Daniel-Pedraglio/ROBO.666.Robotics.Project.Work/Documents/05 - Final Progress Report/Screenshot 2025-01-24 at 12.50.59.jpg

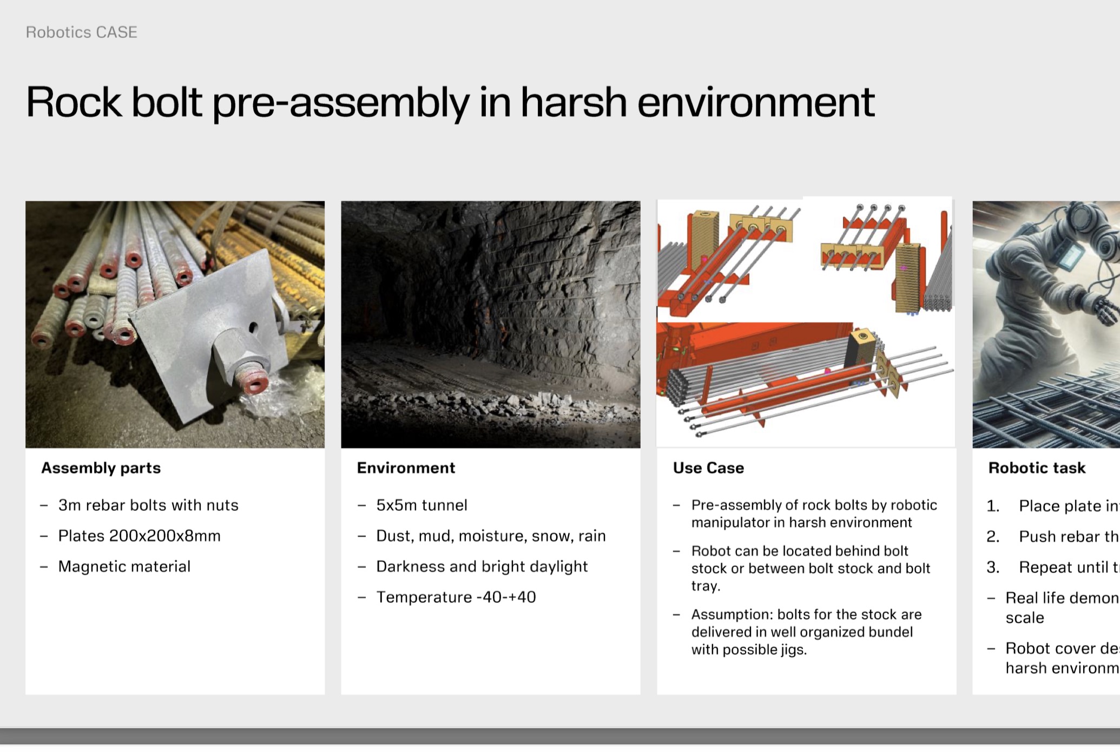
Documents/05 - Final Progress Report/Screenshot 2025-01-24 at 12.50.59.jpg
