Daniel-Pedraglio/ROBO.666.Robotics.Project.Work/Documents/06 - Final Report/Poster_Group2_IndustrialRobotsInHarshConditions.jpg

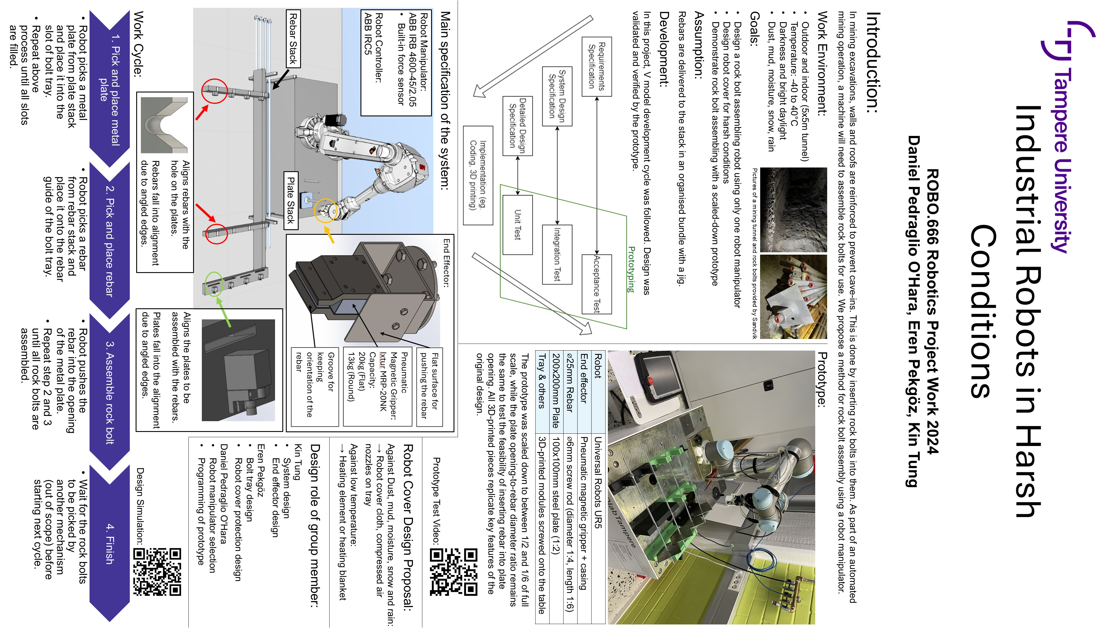
Documents/06 - Final Report/Poster_Group2_IndustrialRobotsInHarshConditions.jpg
