Daniel-Pedraglio/ROBO.666.Robotics.Project.Work/Documents/03 - Progress Report 1/Project Review 1.pptx

## Industrial robot in harsh conditions

Kin Tung
Eren Pekgöz
Daniel Pedraglio O'Hara

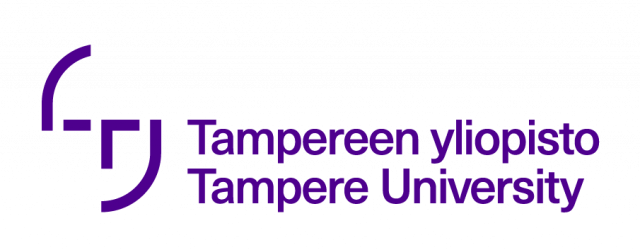
[picture p13: figure]

## Current Project Status

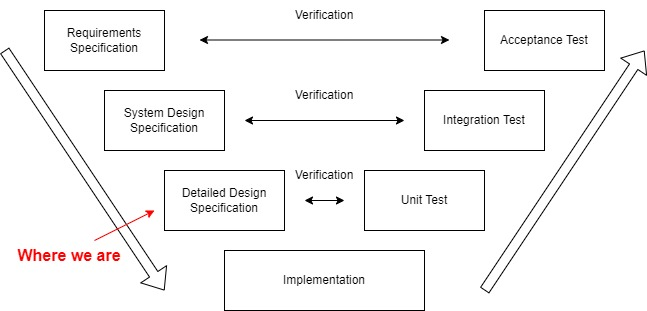
[picture p14: figure]

## Project Schedule Update

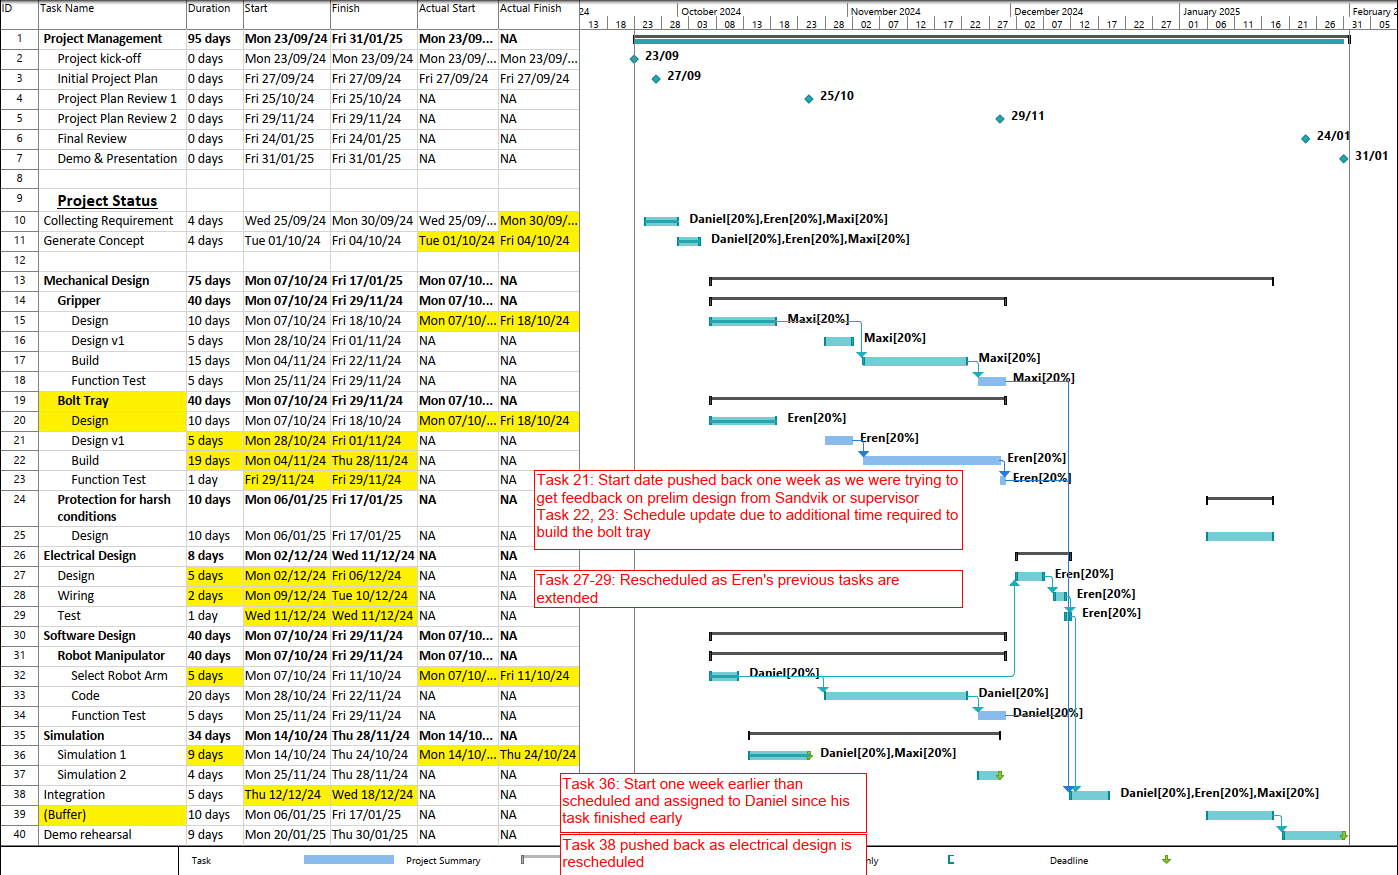
[picture p15: figure]

## Quick recap on requirements

- Main Goal:
Design a robot to assemble rock bolts (Rebar + Steel Plate)
- Environmental Conditions
  - Operating Environment: Indoor and outdoor.
  - Temperature Range: –40 to +40 °C.
  - Lighting Conditions: All lighting conditions, including direct sunlight and complete darkness.
  - Environmental factors: Dust, mud, moisture, snow and rain.
- Specification of materials
  - Steel Plate:
    - Dimension: 200x200x8 mm
    - Weight: 2.51kg
  - Rebar:
    - Dimension: 25mm Dia x 3000mm long
    - Weight: 11.56kg

Steel Weight Calculator, Steel Express
https://www.steelexpress.co.uk/steel-weight-calculator.html

## System Architecture

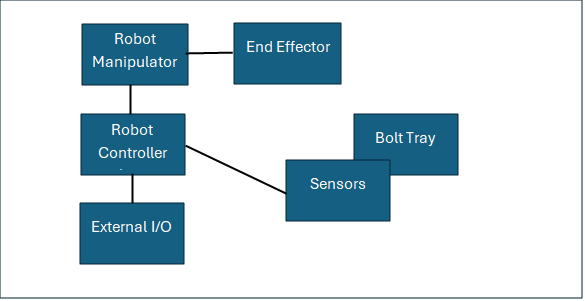
[picture p16: figure]

## Process Flow

Step 1: Initialisation of system.
Step 2: Robot picks up plate.
Step 3: Robot places the plate on the bolt tray.
Step 4: Repeat step 2 and 3 until 4 plates are placed on the bolt tray.
Step 5: Robot places the rebar on the bolt tray.
Step 6: Robot pushes the rebar into the plate.
Step 7: Repeat step 5 – 6 until bolt tray has 4 assembled rebars.
Step 8: Robot returns to home position and stand by.

## Bolt Tray

- Material: Steel construction for durability and strength
- Temperature Resistant: Can operate in both high and low temperature environments
- No moving parts: Ensures reliability, reduces maintenance need
- Fail-safe: Rebars remain secure even in power outages

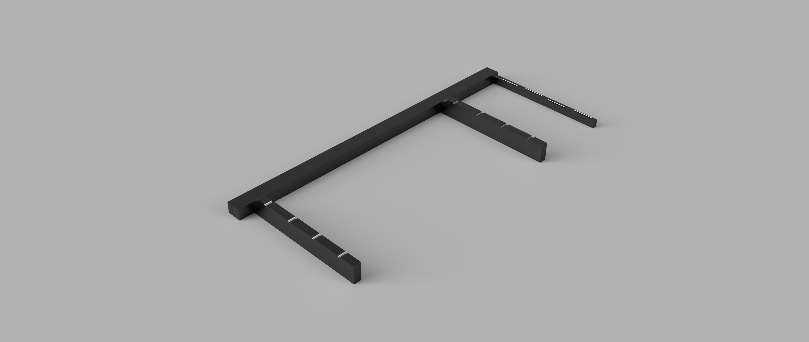
[picture p17: figure]
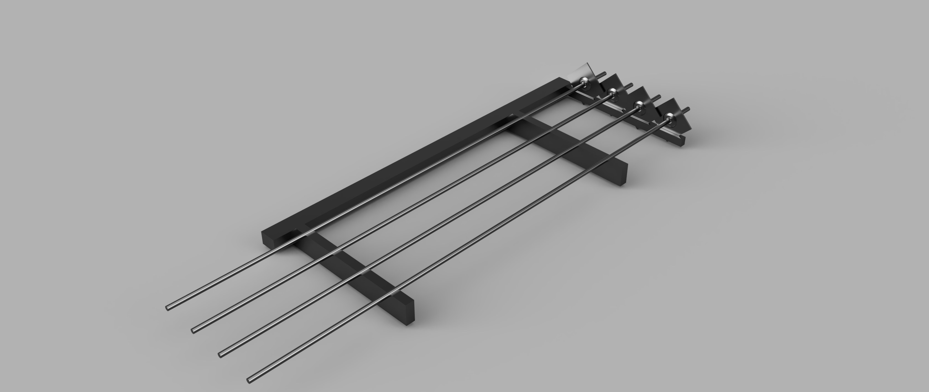
[picture p18: figure]

## Sensors on Bolt Tray

Sensor Type | Advantages | Disadvantages
Inductive Proximity Sensor | No moving parts, detects metal | Cannot detect non-metallic foreign objects
Limit Switch | Easy implementation, no calibration | Mechanical wear
Weight Sensor | High accuracy | Require a rather complex mechanical design of the bolt tray compared to other sensors
Laser Distance Sensor | 2 sensors are enough for the entire tray | Does not perform well with cylindrical or round objects

## Proposed Sensor

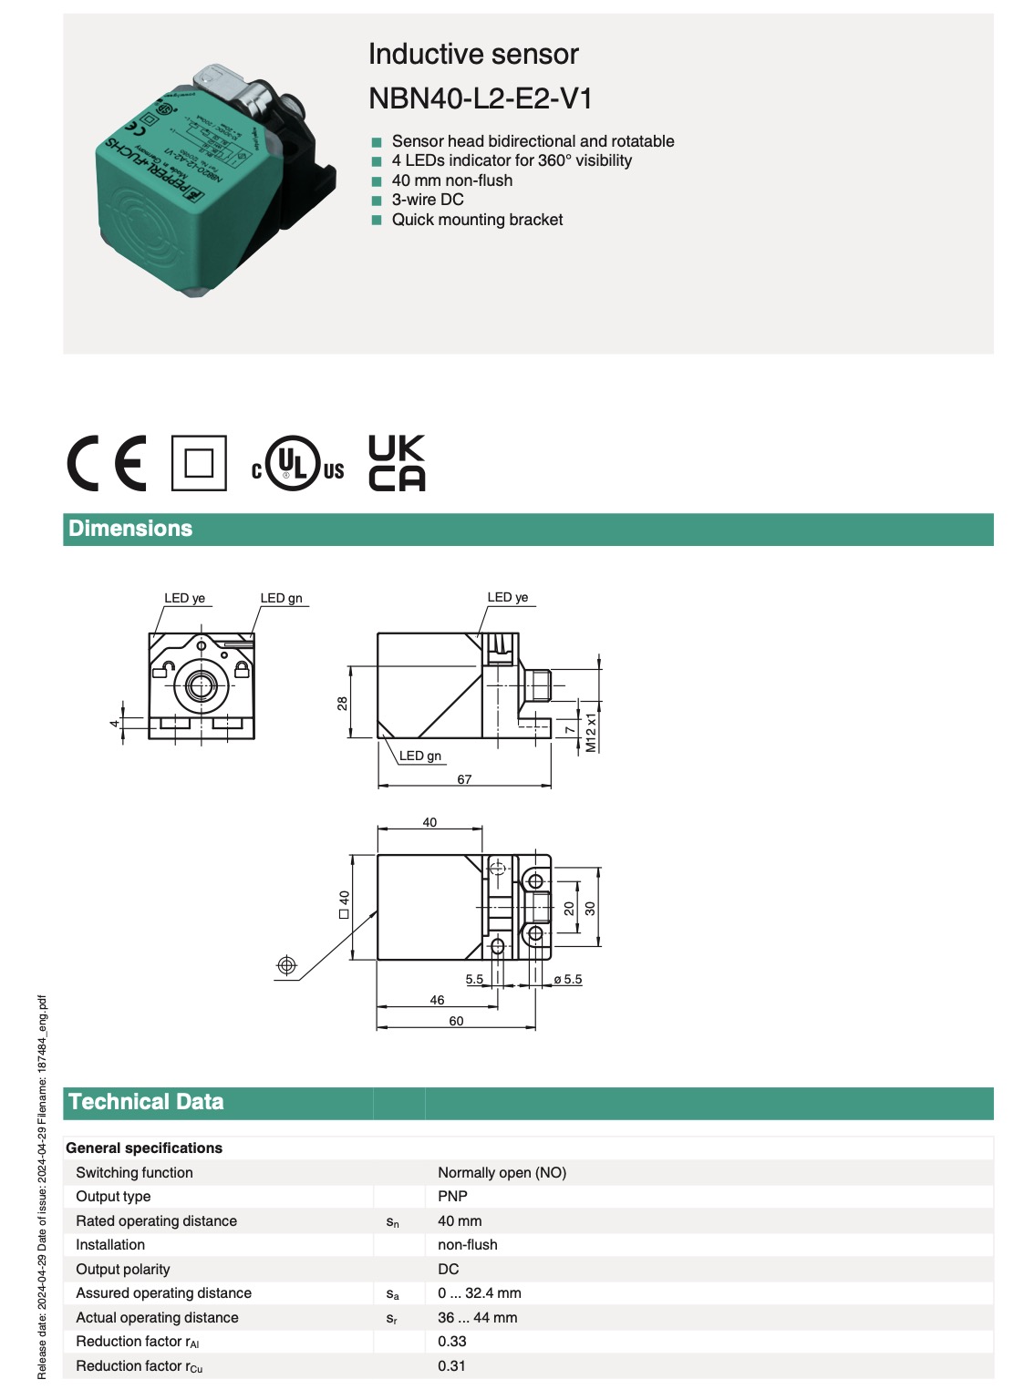
[picture p19: figure]

Pepperl+Fuchs NBN40-L2-E2-V1:
Operating Distance 0...44mm
Normally Open Switch Mechanism
10-30V DC Operating Voltage

## End Effector (1/3)

Functions:
  1. Pick and plate rebar
  2. Pick and plate metal plate
  3. Push rebar into the plate

## End Effector (2/3)

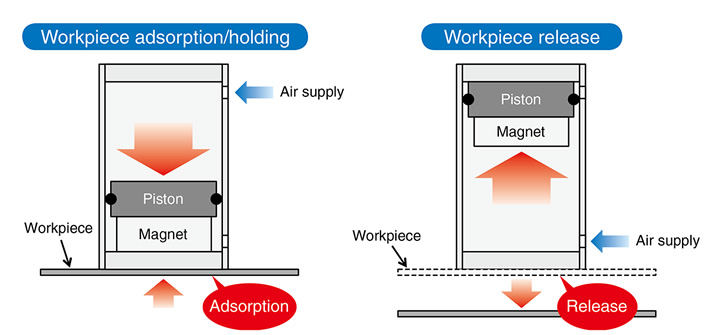
[picture p20: figure]

https://www.smcworld.com/newproducts/en/mhm/images/02b.jpg

- Magnetic Gripper
  - Magnetic force stronger in low temperature
  - No external moving parts
    - Lubrication not necessary => No frozen lubricant problem
    - No frozen joint problem in wet, sub-zero temperature
- Pneumatic Magnetic Gripper
  - Permanent magnet
  - Fail-safe design
    - pneumatic pressure/power = off
    - no pneumatic pressure/no power = on

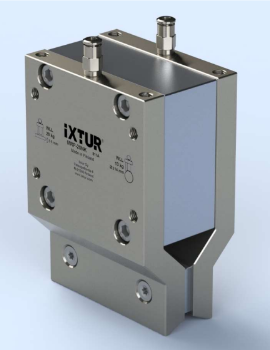
[picture p21: figure]

IXTUR MRP-20NK
- IP67
- Lifting capacity with Safety Factor 3 = 13kg for solid round object (ø≥14mm)

IXTUR MRP-20NK Brochure
https://www.ixtur.com/wp-content/uploads/2023/08/Brochure_MRP-20NK_ENG112018.pdf

## End Effector (3/3)

- Rest of the end effector made of 304 stainless steel or other non-magnetic materials

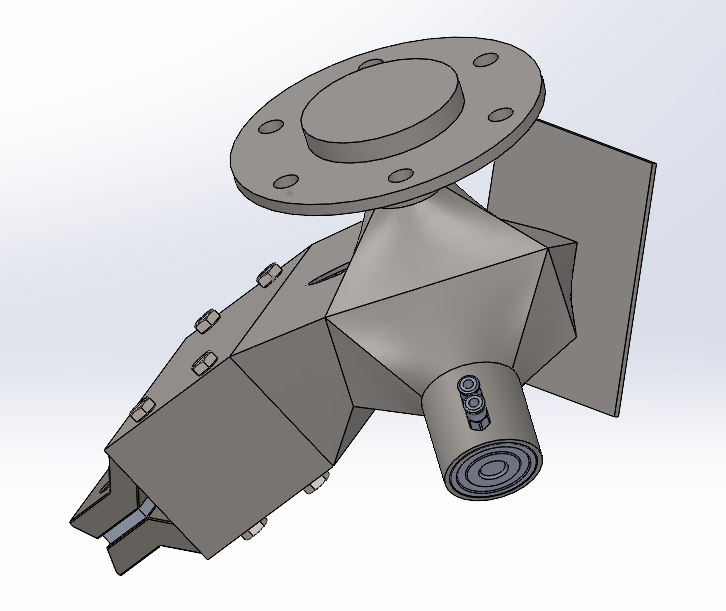
[picture p22: figure]
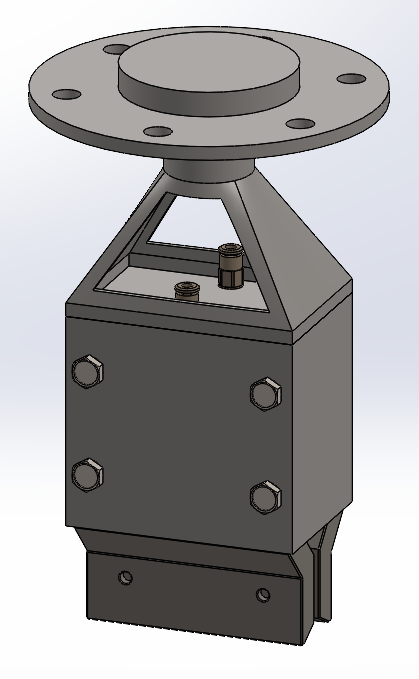
[picture p23: figure]
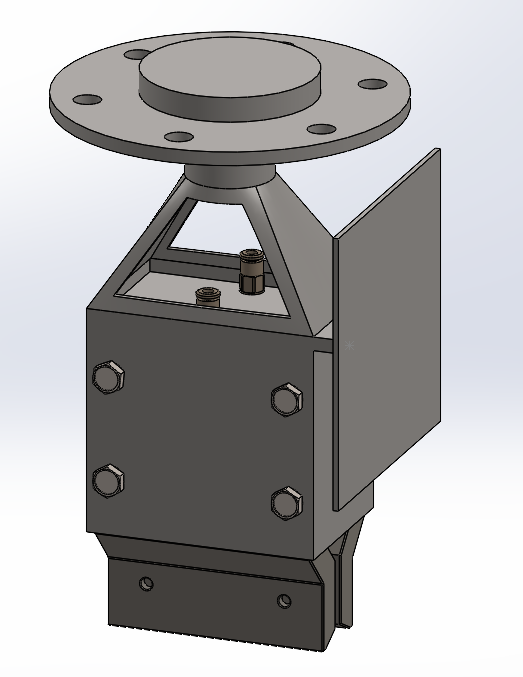
[picture p24: figure]

Ver. 0

Ver. 0.1

Ver. 0.2

## Robot Manipulator Requirements

- Reach from edge of structure with end effector: 1920 mm.
- Good work envelope for objects near and up to 400 mm below it.
- Payload of 15,5 kg at 1155 mm.
- Available in Visual Components.

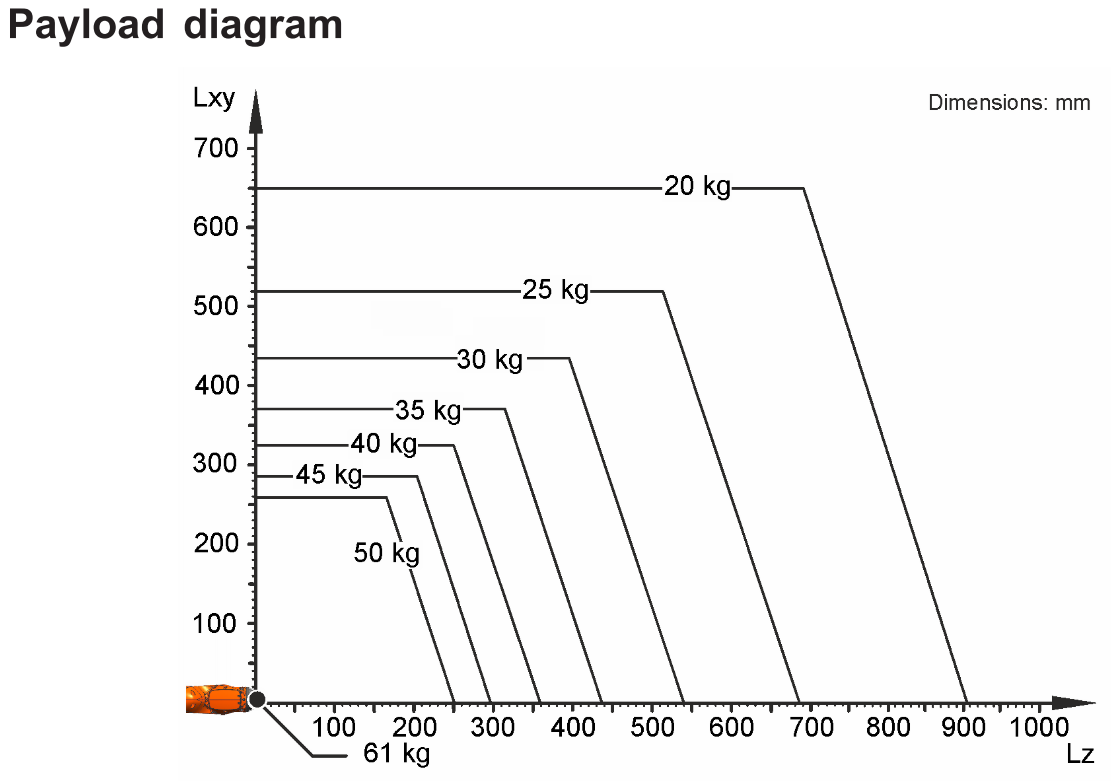
[picture p25: figure]

## Robot Manipulator (1/2)

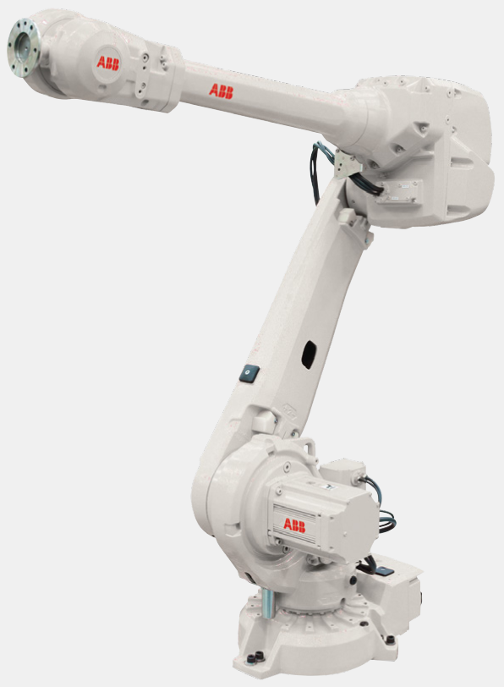
[picture p26: figure]

- ABB IRB 4600-45/2.05
- Reach: 2.05m
- Payload: 45kg
- IP67

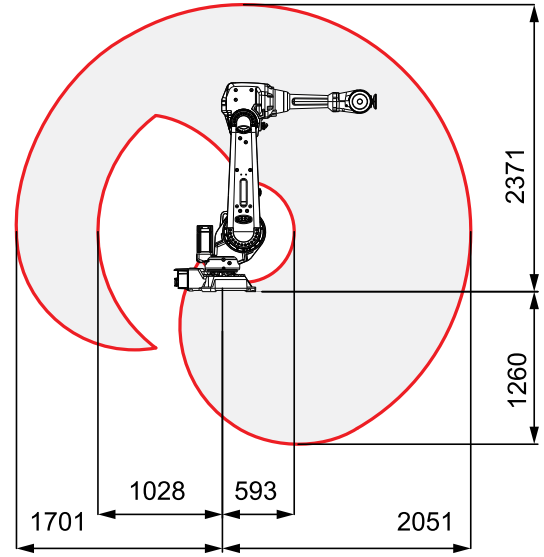
[picture p27: figure]

## Robot Manipulator (2/2)

- Electrical connection: 200-600 V, 50-60 Hz
- Weight: 445kg
- Operating temperature: 5° to 45° C
  - Will require heating in colder environments
- Humidity: max 95%

## Alternative Robot Manipulators

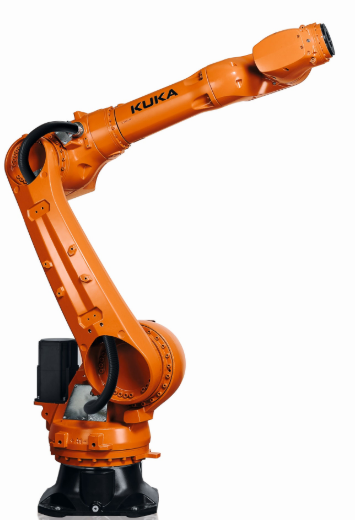
[picture p28: figure]

- Kuka KR 50 R2100
  - 5 kg more payload, 51mm more reach, operates from 0° to 55° C.
  - Almost 20% heavier.

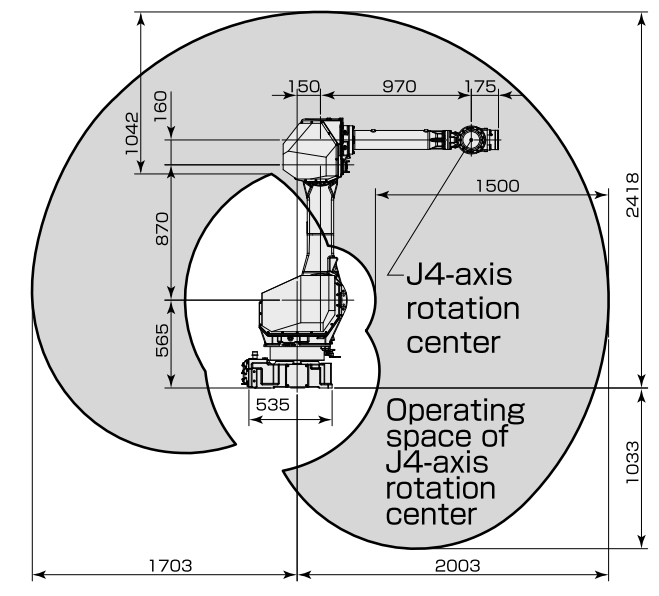
[picture p29: figure]

- Fanuc M-710/50-20C-5X
  - 5kg more payload, operates from 0° to 45° C.
  - 20% heavier, less humidity allowed, worse work envelope due to 5 joints

## Simulation

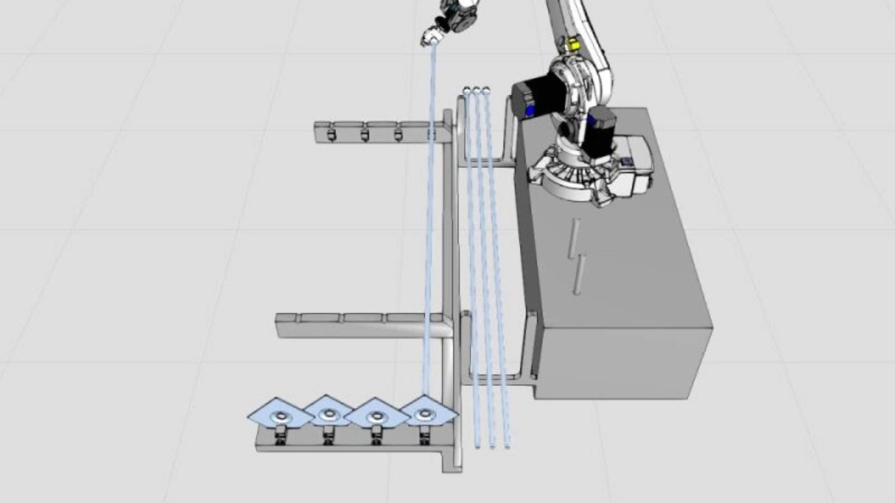
[picture p30: figure]

## From Now to Next Progress Review

- Design v1, build and functional test for end effector and bolt tray*
- Coding robot manipulator*
*If we manage to get in touch with our supervisor or Sandvik's representative to discuss prototyping

## Q&A

## Thank you!
