Daniel-Pedraglio/ROBO.666.Robotics.Project.Work/Documents/01 - Initial Project Plan/Initial ProjectTimeline.pdf

Start Mon 23/09/24

Finish
Fri 31/01/25
30 Sep '24 | 14 Oct '24 | 28 Oct '24 | 11 Nov '24 | 25 Nov '24 | 09 Dec '24 | 23 Dec '24 | 06 Jan '25 | 20 Jan '25 Gripper
| | Ge Ge | Mon 07/10/24 - Fri 29/11/24 Mon 07/10/24 - Fri 29/11/24 | Protection for h Mon 06/01/25 - Colle Wed Protection for h Mon 06/01/25 - Colle Wed
Tray Tray Mon 07/10/24 - Mon 04/11/24 Mon 07/10/24 - Mon 04/11/24 | Electrical Design Electrical Design
Mon 18/11/24 - Fri 06/12/24 Robot Arm

Mon 07/10/24 - Fri 29/11/24

Tu | Demo rehears Mon 20/01/25 Inte Mon Today

Start Mon 23/09/24

Finish
Fri 31/01/25
30 Sep '24 | 14 Oct '24 | 28 Oct '24 | 11 Nov '24 | 25 Nov '24 | 09 Dec '24 | 23 Dec '24 | 06 Jan '25 | 20 Jan '25 Gripper

Mon 18/11/24 - Fri 06/12/24 Robot Arm

Mon 07/10/24 - Fri 29/11/24

Tu | Demo rehears Mon 20/01/25 Inte Mon
