Daniel-Pedraglio/ROBO.666.Robotics.Project.Work/Documents/11 - Requirements Specification/Requirements from Sandvik.pdf

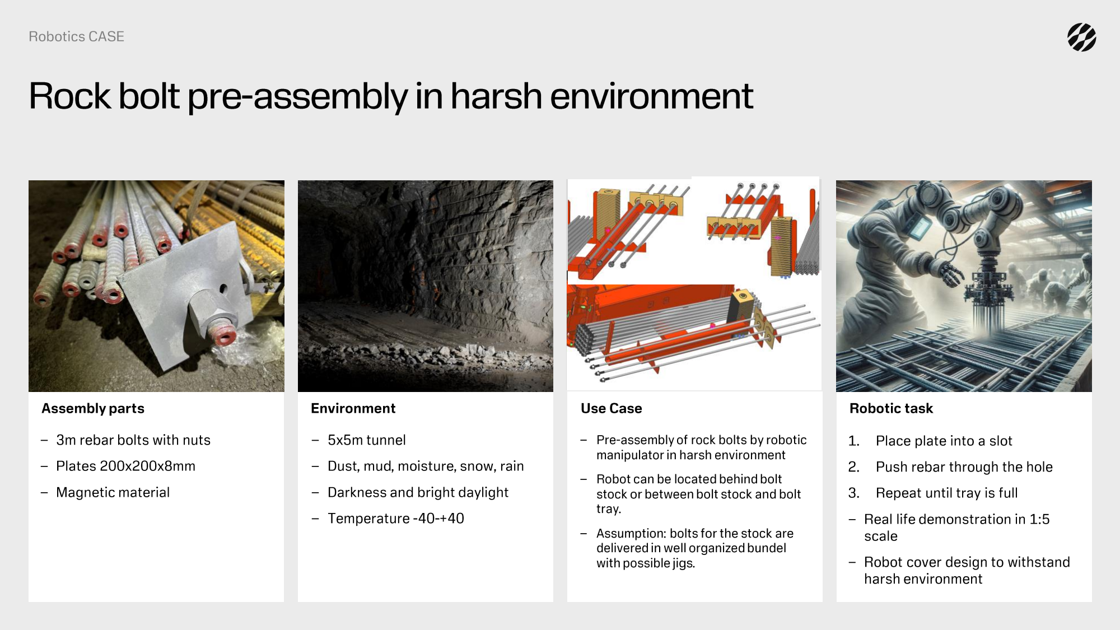
[picture p73: page 2]
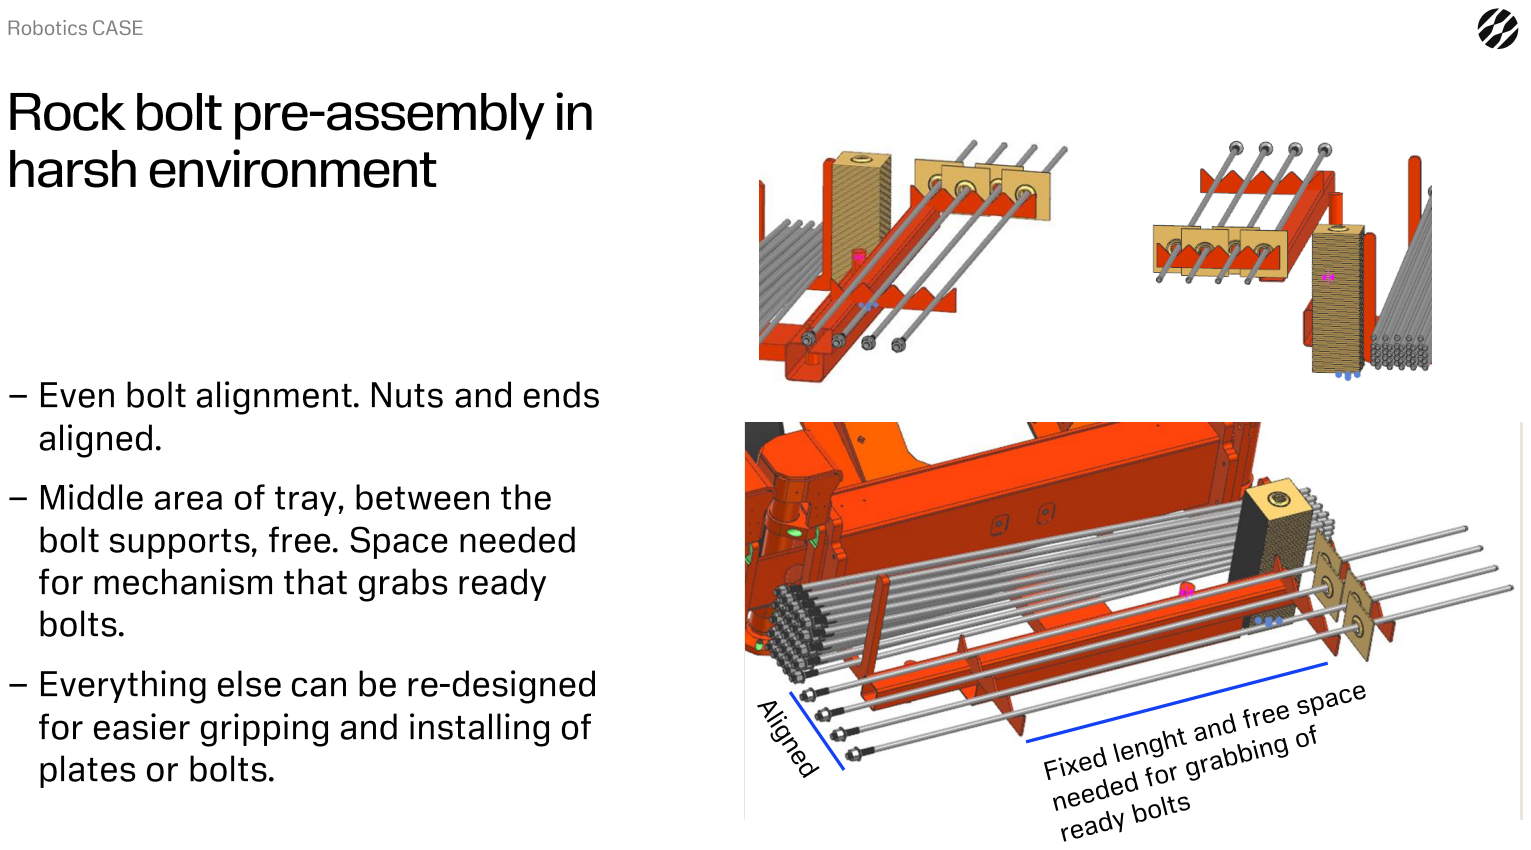
[picture p74: page 3]
