Daniel-Pedraglio/ROBO.666.Robotics.Project.Work/Design/Simulation/Tunnel1.png

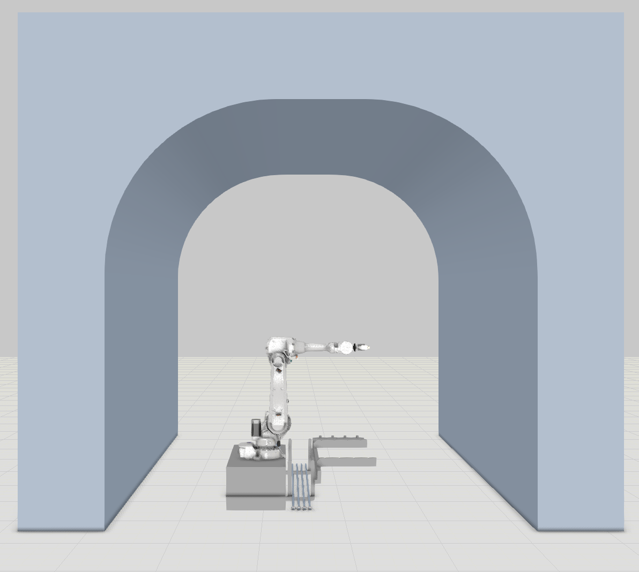
Design/Simulation/Tunnel1.png
