Daniel-Pedraglio/ROBO.666.Robotics.Project.Work/Design/Simulation/Tunnel2.png

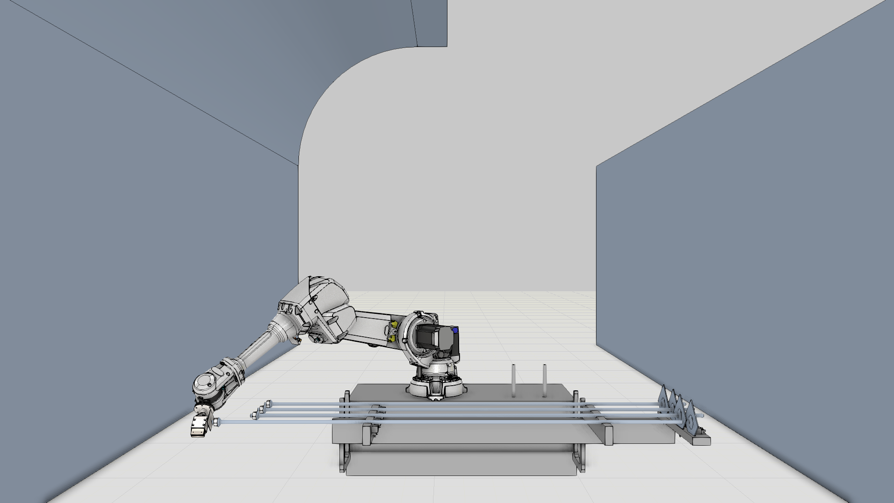
Design/Simulation/Tunnel2.png
