Daniel-Pedraglio/ROBO.666.Robotics.Project.Work/Documents/11 - Requirements Specification/Project Introduction Slide.jpg

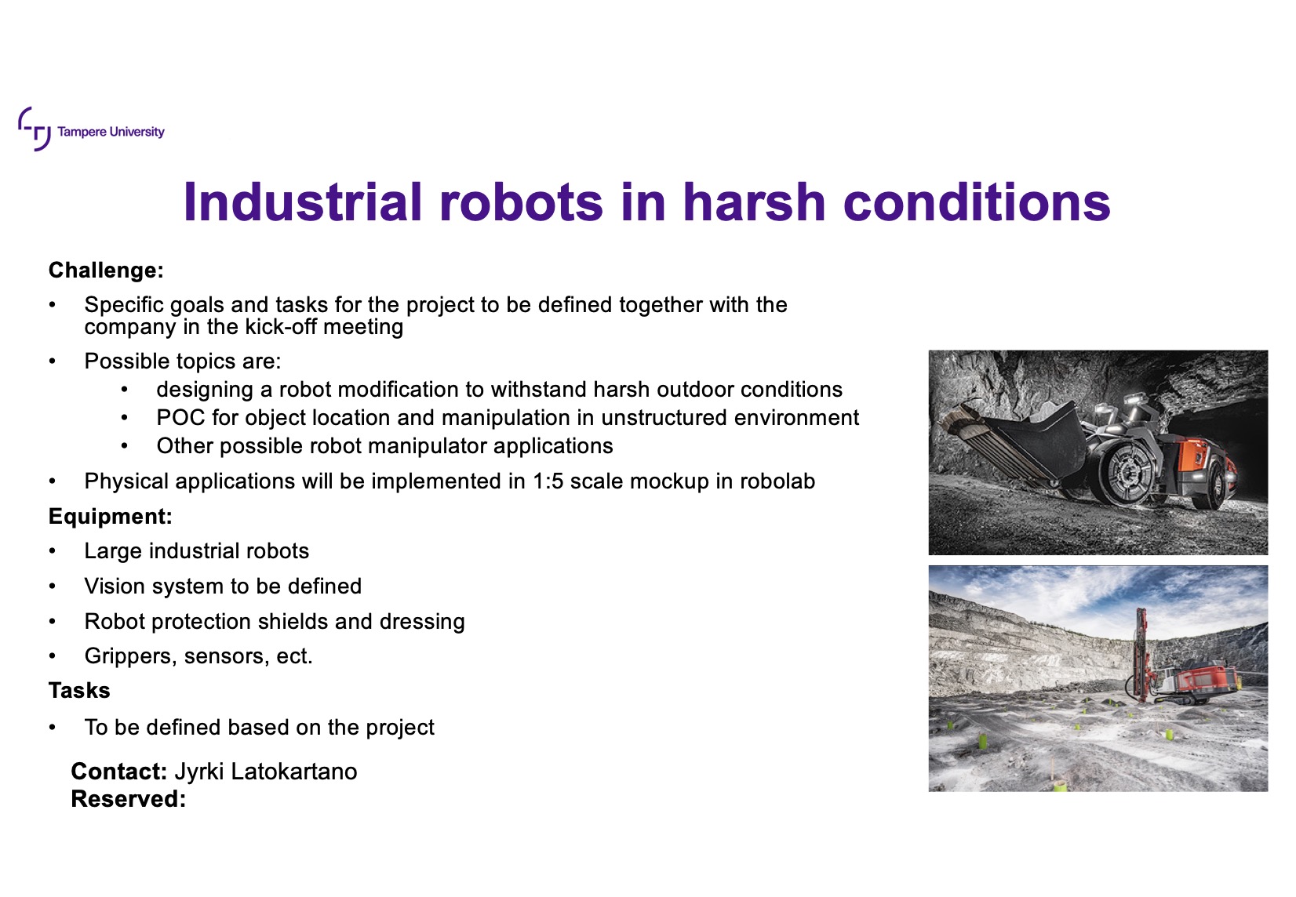
Documents/11 - Requirements Specification/Project Introduction Slide.jpg
