Daniel-Pedraglio/ROBO.666.Robotics.Project.Work/Design/Material CAD/Tunnel.SLDPRT

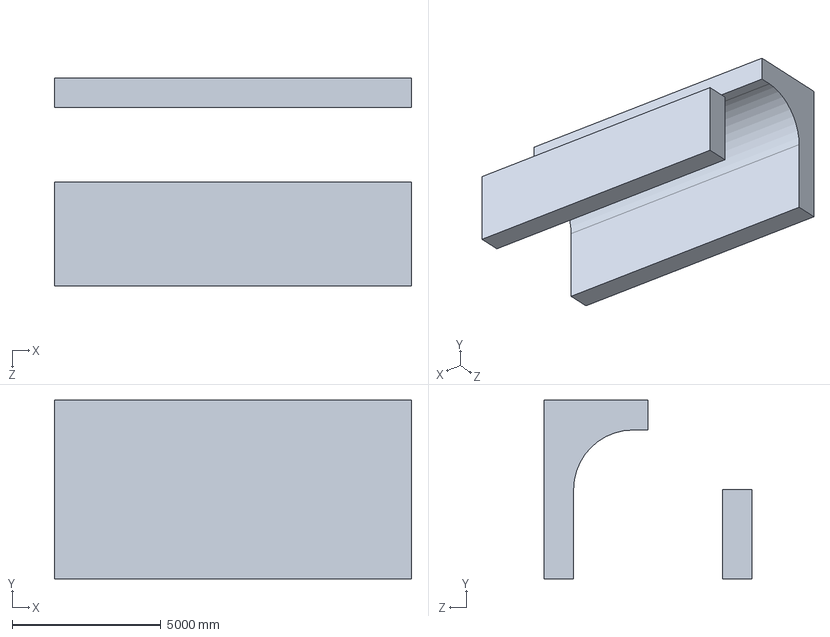
[picture p78: CAD file, 2025-01-27]
Design/Material CAD/Tunnel.SLDPRT
12000.0 x 6000.0 x 7000.0 mm
