Daniel-Pedraglio/ROBO.666.Robotics.Project.Work/Prototype/End Effector/3D Print/Adaptor(Upper).3mf

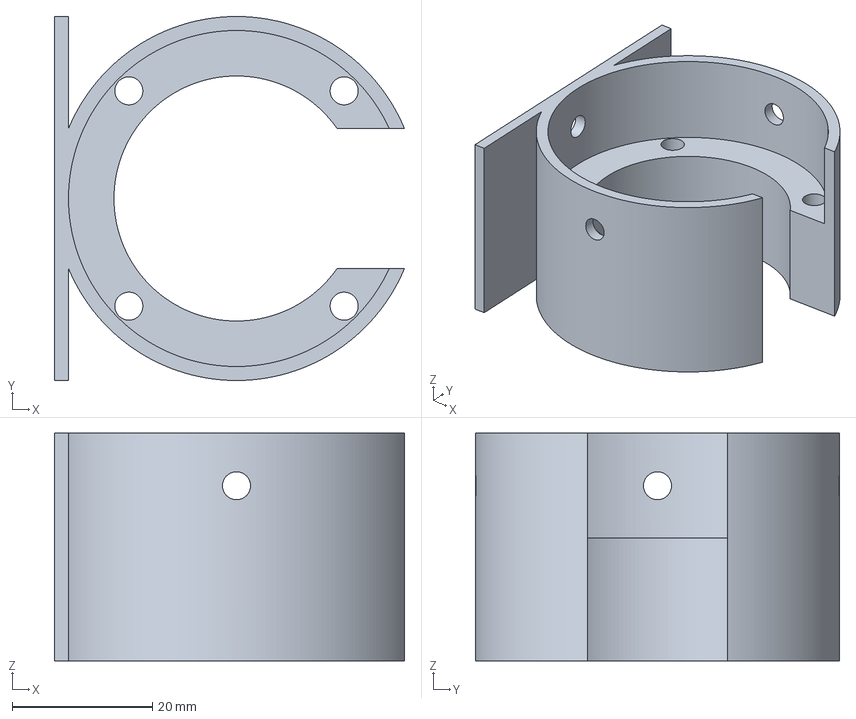
[picture p79: CAD file, 2025-01-27]
Prototype/End Effector/3D Print/Adaptor(Upper).3mf
50.0 x 52.0 x 32.5 mm
