Daniel-Pedraglio/ROBO.666.Robotics.Project.Work/Prototype/End Effector/CAD/Adaptor_groove0.5.SLDPRT

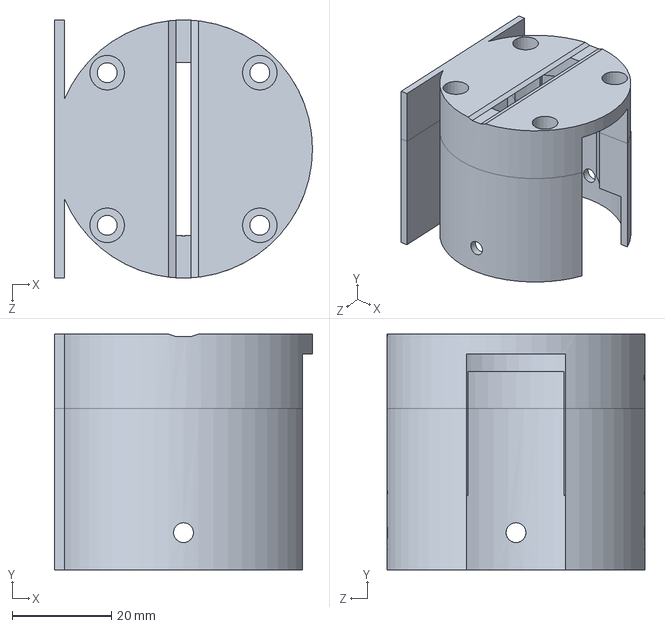
[picture p80: CAD file, 2025-01-27]
Prototype/End Effector/CAD/Adaptor_groove0.5.SLDPRT
52.0 x 47.5 x 52.0 mm
