Daniel-Pedraglio/ROBO.666.Robotics.Project.Work/Prototype/Material CAD/plate_base_print.step

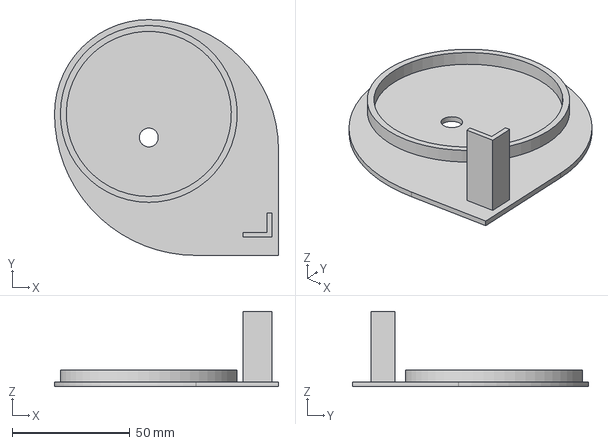
[picture p81: CAD file, 2025-01-27]
Prototype/Material CAD/plate_base_print.step
95.0 x 100.0 x 32.0 mm
