Daniel-Pedraglio/ROBO.666.Robotics.Project.Work/Prototype/End Effector/3D Print/Adaptor(Lower)_groove02.3mf

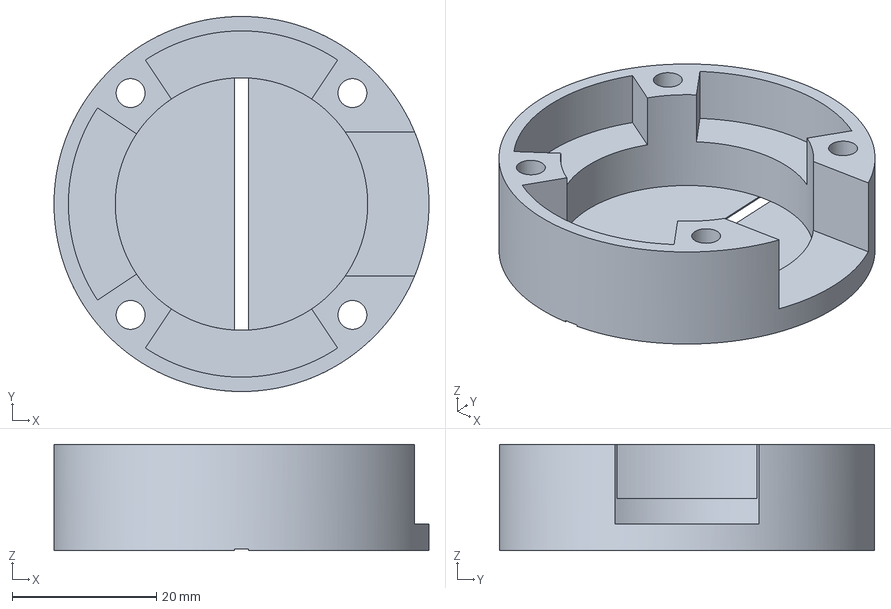
[picture p82: CAD file, 2025-01-27]
Prototype/End Effector/3D Print/Adaptor(Lower)_groove02.3mf
52.0 x 52.0 x 14.7 mm
