Daniel-Pedraglio/ROBO.666.Robotics.Project.Work/Prototype/End Effector/CAD/Adaptor_groove0.2.SLDPRT

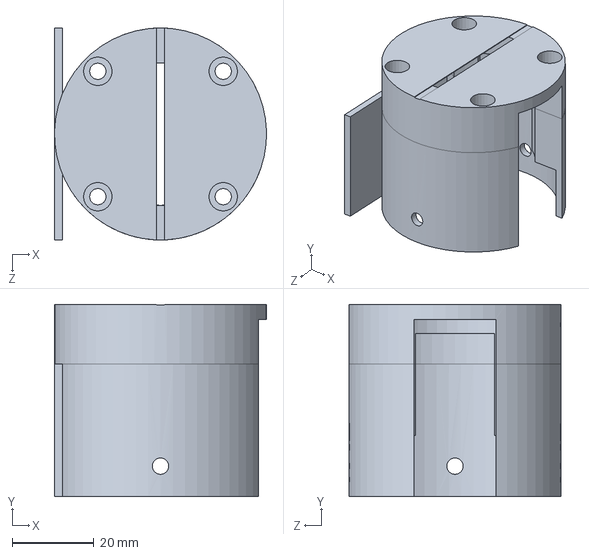
[picture p83: CAD file, 2025-01-27]
Prototype/End Effector/CAD/Adaptor_groove0.2.SLDPRT
52.0 x 47.2 x 52.0 mm
