Daniel-Pedraglio/ROBO.666.Robotics.Project.Work/Prototype/Material CAD/rebar_holder_ladder.step

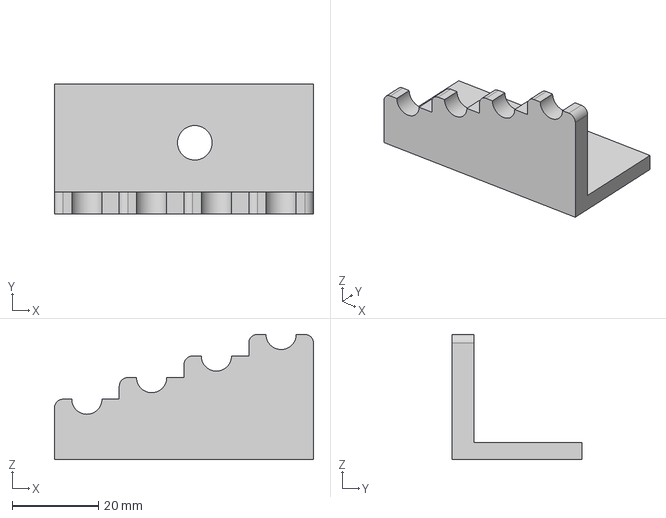
[picture p84: CAD file, 2025-01-27]
Prototype/Material CAD/rebar_holder_ladder.step
60.0 x 30.0 x 29.0 mm
