Daniel-Pedraglio/ROBO.666.Robotics.Project.Work/Prototype/End Effector/3D Print/Adaptor(Lower)_groove05.3mf

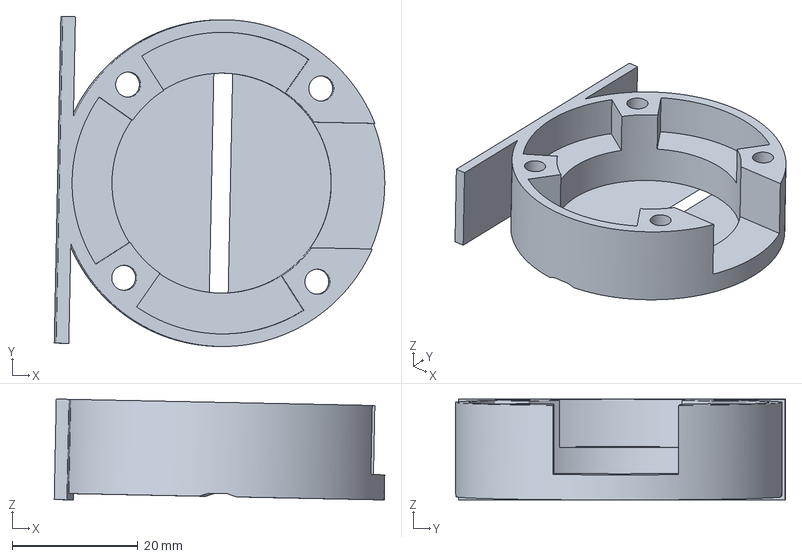
[picture p85: CAD file, 2025-01-27]
Prototype/End Effector/3D Print/Adaptor(Lower)_groove05.3mf
52.6 x 52.5 x 16.1 mm
