Daniel-Pedraglio/ROBO.666.Robotics.Project.Work/Design/Material CAD/Rebar Rack and Plate Stack.STEP

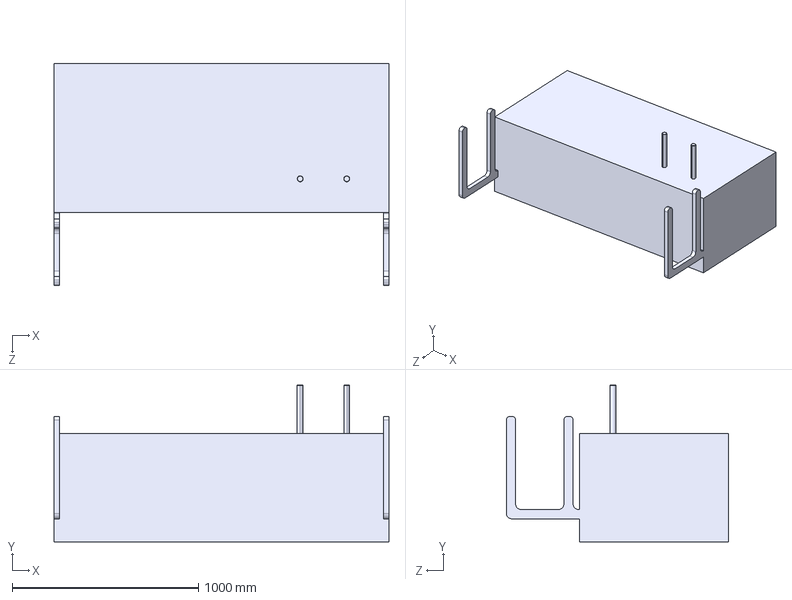
[picture p86: CAD file, 2025-01-27]
Design/Material CAD/Rebar Rack and Plate Stack.STEP
1798.9 x 843.0 x 1193.8 mm
