Daniel-Pedraglio/ROBO.666.Robotics.Project.Work/Design/Bolt Tray/tray_rack_sensors.step

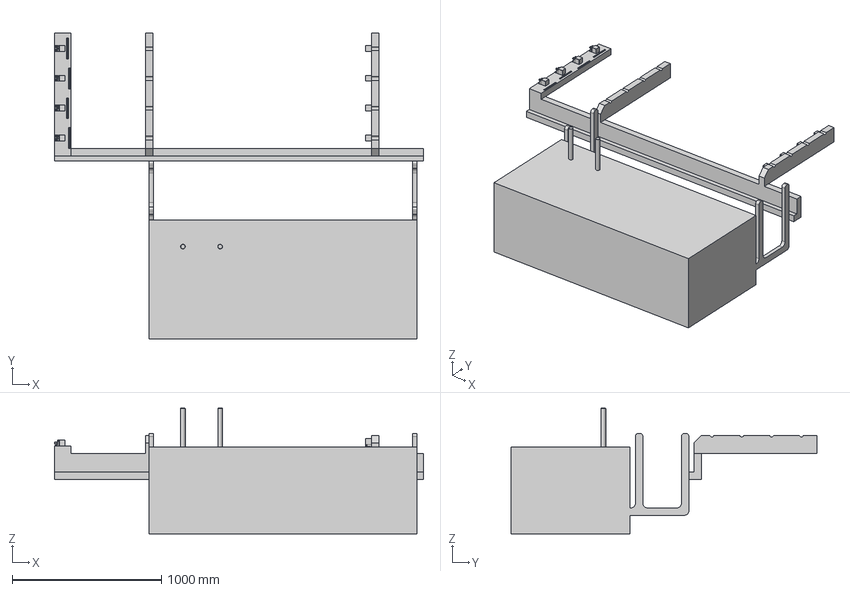
[picture p87: CAD file, 2025-02-04]
Design/Bolt Tray/tray_rack_sensors.step
2476.0 x 2053.8 x 843.0 mm
