Daniel-Pedraglio/ROBO.666.Robotics.Project.Work/Prototype/Bolt Tray/RebarGuide_PrintSlim.step

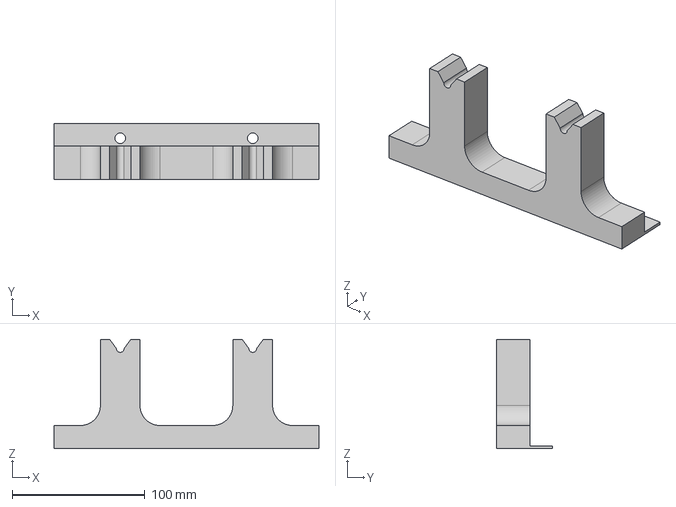
[picture p88: CAD file, 2025-02-04]
Prototype/Bolt Tray/RebarGuide_PrintSlim.step
200.0 x 42.0 x 82.5 mm
