Daniel-Pedraglio/ROBO.666.Robotics.Project.Work/Prototype/Bolt Tray/PlateHolder_PrintSlim.step

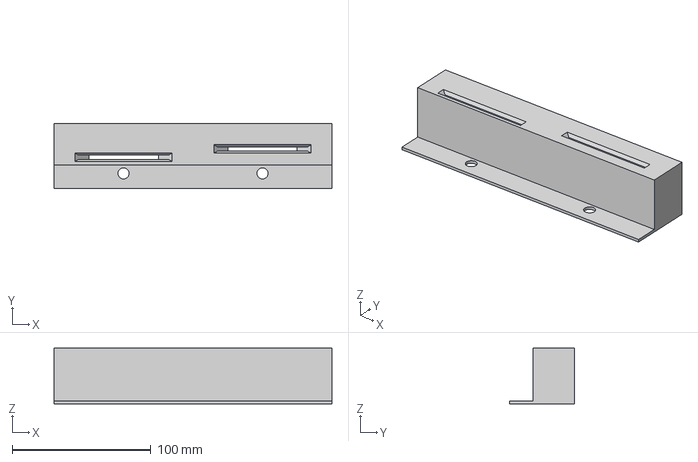
[picture p89: CAD file, 2025-02-04]
Prototype/Bolt Tray/PlateHolder_PrintSlim.step
200.0 x 47.0 x 40.0 mm
