Daniel-Pedraglio/ROBO.666.Robotics.Project.Work/Design/End Effector/CAD/EndEffector_v1.1.SLDASM

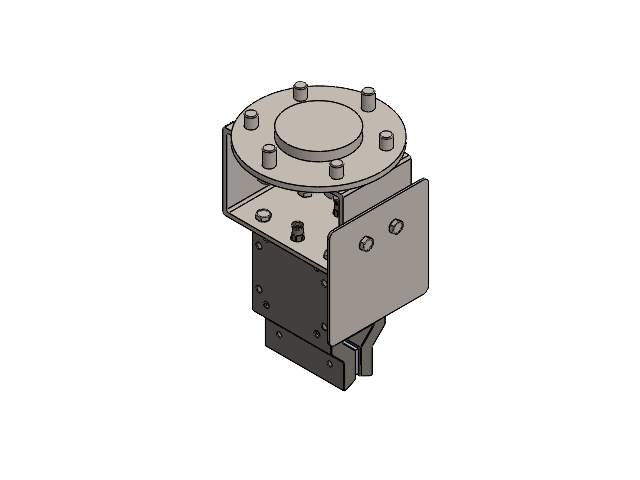
[picture p90: CAD file, 2025-01-27]
Design/End Effector/CAD/EndEffector_v1.1.SLDASM
EndEffector(1Gripper)_v0.4_Flange
EndEffector(1Gripper)_v0.4_Angle
EndEffector(1Gripper)_v0.4_PushPlate
MRP-20NK 3d-model
formed hex screw_am x 12
hex nut style 1_am x 2
