Daniel-Pedraglio/ROBO.666.Robotics.Project.Work/Design/Material CAD/Plate.SLDASM

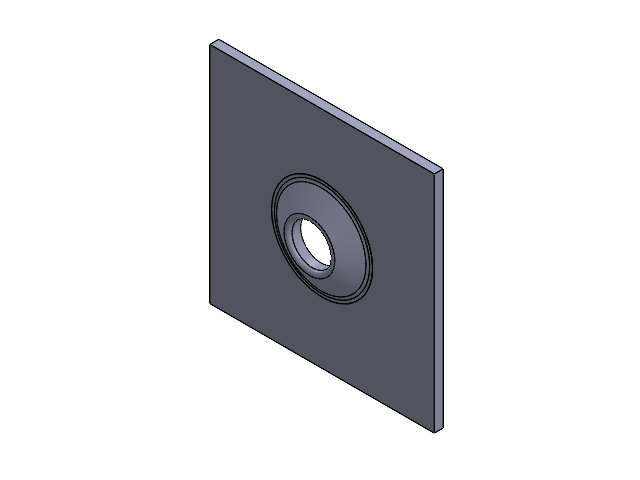
[picture p91: CAD file, 2025-01-27]
Design/Material CAD/Plate.SLDASM
Plate2
Plate1
