Daniel-Pedraglio/ROBO.666.Robotics.Project.Work/Design/Material CAD/Rebar.SLDASM

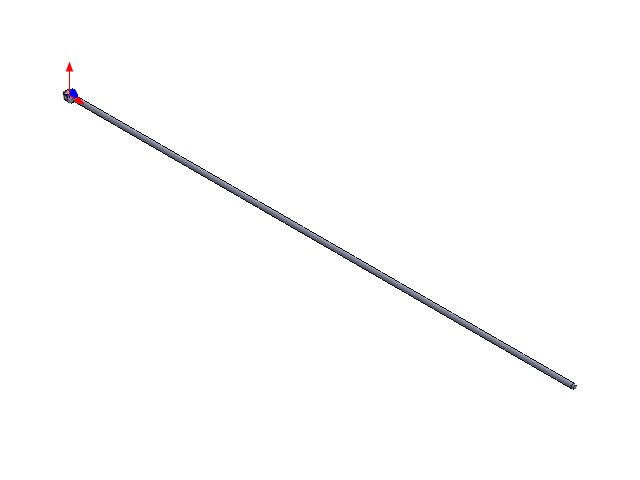
[picture p92: CAD file, 2025-01-27]
Design/Material CAD/Rebar.SLDASM
Rebar
Washer
hex nut style 1 gradeab_iso
