Daniel-Pedraglio/ROBO.666.Robotics.Project.Work/(list of files, cad)

Other CAD files:
Design/Material CAD/Rebar Rack and Plate Stack.SLDPRT
Prototype/Bolt Tray/PlateHolder_PrintSlim.stl
Prototype/Bolt Tray/RebarGuide_PrintSlim.stl
Prototype/Material CAD/plate_base_print.stl
Prototype/Material CAD/rebar_holder_ladder.stl
