Daniel-Pedraglio/ROBO.666.Robotics.Project.Work/Documents/03 - Progress Report 1/Project Schedule (Progress Review 1).pdf

9 | Project Status | | | | NA | NA

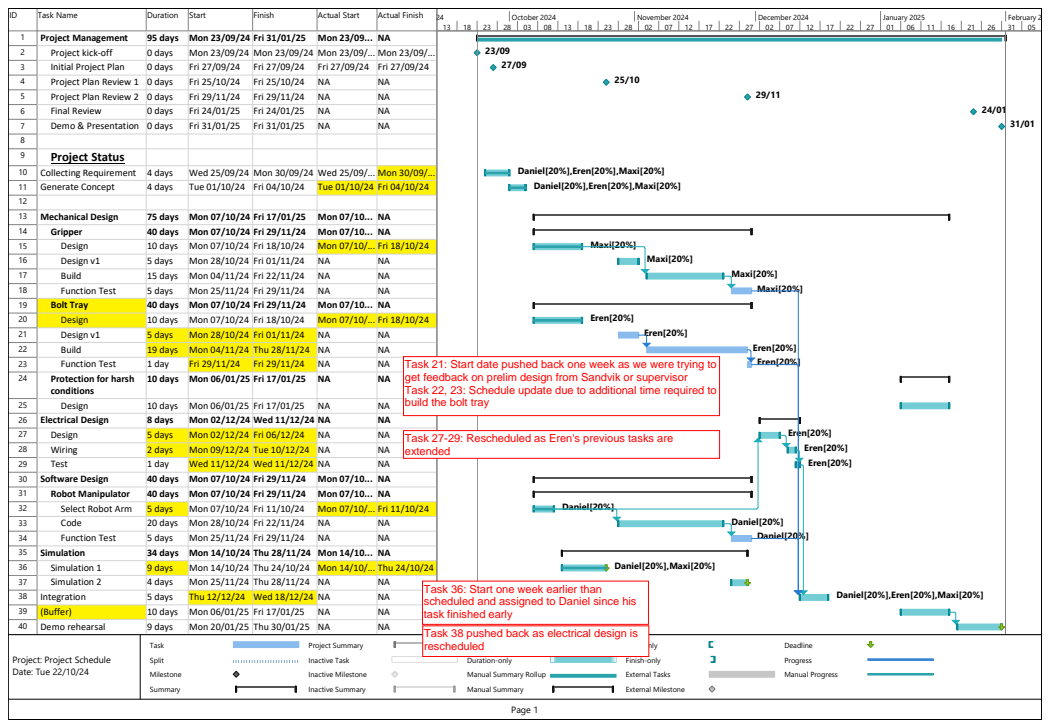
[picture p93: page 1]
Maxi[20%]; Maxi[20%] Maxi[20%]; Eren[20%]; Eren[20%] Eren[20%]; Eren[20%] Eren[20%] Eren[20%]; Daniel[20%]; Daniel[20%] Daniel[20%]; Daniel[20%],Maxi[20%]; October 2024; November 2024; December 2024; January 2025; February 2025; Task; Split; Summary; Project Summary; Inactive Task; Inactive Summary; Manual Task; Duration-only; Manual Summary; Start-only; Finish-only; External Milestone; Deadline; Progress; Page 1

ID | Task Name | Duration | Start | Finish | Actual Start | Actual Finish
1 | Project Management | 95 days | Mon 23/09/24 Fri 31/01/25 | | Mon 23/09... | NA
2 | Project kick-off | 0 days | Mon 23/09/24 | Mon 23/09/24 | Mon 23/09/...
3 | Initial Project Plan | 0 days | Fri 27/09/24 | Fri 27/09/24 | Fri 27/09/24 | Fri 27/09/24
4 | Project Plan Review 1 | 0 days | Fri 25/10/24 | Fri 25/10/24 | NA | NA
5 | Project Plan Review 2 | 0 days | Fri 29/11/24 | Fri 29/11/24 | NA | NA
6 | Final Review | 0 days | Fri 24/01/25 | Fri 24/01/25 | NA | NA
7 | Demo & Presentation | 0 days | Fri 31/01/25 | Fri 31/01/25 | NA | NA

10 | Collecting Requirement | 4 days | Wed 25/09/24 | Mon 30/09/24 | Wed 25/09/... Mon 30/09/...
11 | Generate Concept | 4 days | Tue 01/10/24 | Fri 04/10/24 | Tue 01/10/24 | Fri 04/10/24
12
13 | Mechanical Design | 75 days | Mon 07/10/24 Fri 17/01/25 | | Mon 07/10... | NA
14 | Gripper | 40 days | Mon 07/10/24 Fri 29/11/24 | | Mon 07/10... | NA
15 | Design | 10 days | Mon 07/10/24 | Fri 18/10/24 | Mon 07/10/... Fri 18/10/24
16 | Design v1 | 5 days | Mon 28/10/24 | Fri 01/11/24 | NA | NA
17 | Build | 15 days | Mon 04/11/24 | Fri 22/11/24 | NA | NA
18 | Function Test | 5 days | Mon 25/11/24 | Fri 29/11/24 | NA | NA
19 | Bolt Tray | 40 days | Mon 07/10/24 Fri 29/11/24 | | Mon 07/10... | NA
20 | Design | 10 days | Mon 07/10/24 | Fri 18/10/24 | Mon 07/10/... Fri 18/10/24
21 | Design v1 | 5 days | Mon 28/10/24 | Fri 01/11/24 | NA | NA
22 | Build | 19 days | Mon 04/11/24 | Thu 28/11/24 | NA | NA
23 | Function Test | 1 day | Fri 29/11/24 | Fri 29/11/24 | NA | NA
24 Protection for harsh | conditions | 10 days | Mon 06/01/25 Fri 17/01/25 | | NA | NA

Daniel[20%],Eren[20%],Maxi[20%]

25 | Design | 10 days | Mon 06/01/25 | Fri 17/01/25 | NA | NA
26 | Electrical Design | 8 days | Mon 02/12/24 Wed 11/12/24 NA | | | NA
27 | Design | 5 days | Mon 02/12/24 | Fri 06/12/24 | NA | NA
28 | Wiring | 2 days | Mon 09/12/24 | Tue 10/12/24 | NA | NA
29 | Test | 1 day | Wed 11/12/24 | Wed 11/12/24 | NA | NA
30 | Software Design | 40 days | Mon 07/10/24 Fri 29/11/24 | | Mon 07/10... | NA
31 | Robot Manipulator | 40 days | Mon 07/10/24 Fri 29/11/24 | | Mon 07/10... | NA
32 | Select Robot Arm | 5 days | Mon 07/10/24 | Fri 11/10/24 | Mon 07/10/... Fri 11/10/24
33 | Code | 20 days | Mon 28/10/24 | Fri 22/11/24 | NA | NA
34 | Function Test | 5 days | Mon 25/11/24 | Fri 29/11/24 | NA | NA
35 | Simulation | 34 days | Mon 14/10/24 Thu 28/11/24 | | Mon 14/10... | NA
36 | Simulation 1 | 9 days | Mon 14/10/24 | Thu 24/10/24 | Mon 14/10/... Thu 24/10/24
37 | Simulation 2 | 4 days | Mon 25/11/24 | Thu 28/11/24 | NA | NA
38 | Integration | 5 days | Thu 12/12/24 | Wed 18/12/24 | NA | NA
39 | (Buffer) | 10 days | Mon 06/01/25 | Fri 17/01/25 | NA | NA
40 | Demo rehearsal | 9 days | Mon 20/01/25 | Thu 30/01/25 | NA | NA

Project: Project Schedule Date: Tue 22/10/24 | Milestone Inactive Milestone Manual Summary Rollup External Tasks Manual Progress
