Daniel-Pedraglio/ROBO.666.Robotics.Project.Work/Documents/04 - Progress Report 2/Project Schedule (Progress Review 2).pdf

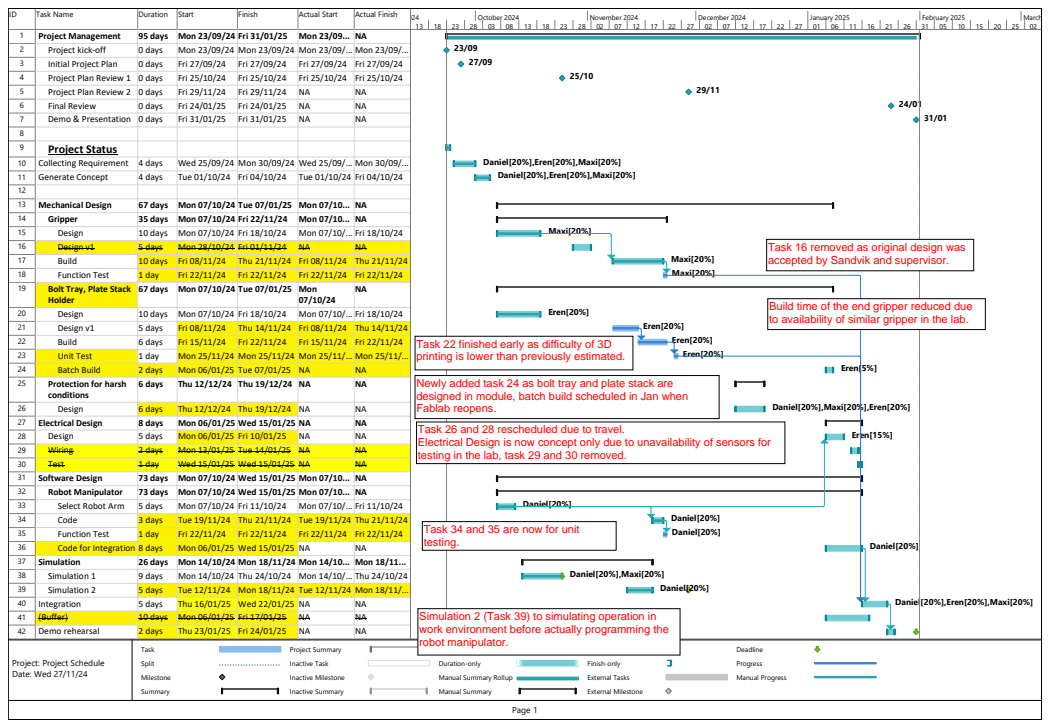
[picture p94: page 1]
Maxi[20%]; Maxi[20%] Maxi[20%]; Eren[20%]; Eren[20%] Eren[20%] Eren[20%]; Eren[5%]; Eren[15%]; Daniel[20%]; Daniel[20%] Daniel[20%]; Daniel[20%],Maxi[20%] Daniel[20%]; October 2024; November 2024; December 2024; January 2025; February 2025; March 2025; Task Split; Summary; Project Summary Inactive Task; Inactive Summary; Manual Task Duration-only; Manual Summary; Start-only Finish-only; External Milestone; Deadline Progress; Page 1

ID | Task Name | Duration | Start | Finish | Actual Start | Actual Finish
1 | Project Management | 95 days | Mon 23/09/24 Fri 31/01/25 | | Mon 23/09... | NA
2 | Project kick-off | 0 days | Mon 23/09/24 | Mon 23/09/24 | Mon 23/09/...
3 | Initial Project Plan | 0 days | Fri 27/09/24 | Fri 27/09/24 | Fri 27/09/24 | Fri 27/09/24
4 | Project Plan Review 1 | 0 days | Fri 25/10/24 | Fri 25/10/24 | Fri 25/10/24 | Fri 25/10/24
5 | Project Plan Review 2 | 0 days | Fri 29/11/24 | Fri 29/11/24 | NA | NA
6 | Final Review | 0 days | Fri 24/01/25 | Fri 24/01/25 | NA | NA
7 | Demo & Presentation | 0 days | Fri 31/01/25 | Fri 31/01/25 | NA | NA
9 | Project Status | 1 day | Mon 23/09/24Mon 23/09/24Mon 23/... Mon 23/...
10 | Collecting Requirement | 4 days | Wed 25/09/24 | Mon 30/09/24 | Wed 25/09/... Mon 30/09/...
11 | Generate Concept | 4 days | Tue 01/10/24 | Fri 04/10/24 | Tue 01/10/24 | Fri 04/10/24
12
13 | Mechanical Design | 67 days | Mon 07/10/24 Tue 07/01/25 | | Mon 07/10... | NA
14 | Gripper | 35 days | Mon 07/10/24 Fri 22/11/24 | | Mon 07/10... | NA
15 | Design | 10 days | Mon 07/10/24 | Fri 18/10/24 | Mon 07/10/... Fri 18/10/24
16 | Design v1 | 5 days | Mon 28/10/24 | Fri 01/11/24 | NA | NA
17 | Build | 10 days | Fri 08/11/24 | Thu 21/11/24 | Fri 08/11/24 | Thu 21/11/24
18 | Function Test | 1 day | Fri 22/11/24 | Fri 22/11/24 | Fri 22/11/24 | Fri 22/11/24
19 Bolt Tray, Plate Stack | Holder | 67 days | Mon 07/10/24 Tue 07/01/25 | | Mon 07/10/24 | NA

Daniel[20%],Eren[20%],Maxi[20%]

20 | Design | 10 days | Mon 07/10/24 | Fri 18/10/24 | Mon 07/10/... Fri 18/10/24
21 | Design v1 | 5 days | Fri 08/11/24 | Thu 14/11/24 | Fri 08/11/24 | Thu 14/11/24
22 | Build | 6 days | Fri 15/11/24 | Fri 22/11/24 | Fri 15/11/24 | Fri 22/11/24
23 | Unit Test | 1 day | Mon 25/11/24 | Mon 25/11/24 | Mon 25/11/...
24 | Batch Build | 2 days | Mon 06/01/25 | Tue 07/01/25 | NA | NA
25 Protection for harsh | conditions | 6 days | Thu 12/12/24 | Thu 19/12/24 | NA | NA

26 | Design | 6 days | Thu 12/12/24 | Thu 19/12/24 | NA | NA
27 | Electrical Design | 8 days | Mon 06/01/25 Wed 15/01/25 NA | | | NA
28 | Design | 5 days | Mon 06/01/25 | Fri 10/01/25 | NA | NA
29 | Wiring | 2 days | Mon 13/01/25 | Tue 14/01/25 | NA | NA
30 | Test | 1 day | Wed 15/01/25 | Wed 15/01/25 | NA | NA
31 | Software Design | 73 days | Mon 07/10/24 Wed 15/01/25 Mon 07/10... | | | NA
32 | Robot Manipulator | 73 days | Mon 07/10/24 Wed 15/01/25 Mon 07/10... | | | NA
33 | Select Robot Arm | 5 days | Mon 07/10/24 | Fri 11/10/24 | Mon 07/10/... Fri 11/10/24
34 | Code | 3 days | Tue 19/11/24 | Thu 21/11/24 | Tue 19/11/24 | Thu 21/11/24
35 | Function Test | 1 day | Fri 22/11/24 | Fri 22/11/24 | Fri 22/11/24 | Fri 22/11/24
36 | Code for Integration 8 days | | Mon 06/01/25 | Wed 15/01/25 | NA | NA
37 | Simulation | 26 days | Mon 14/10/24 Mon 18/11/24 Mon 14/10... | | | Mon 18/11...
38 | Simulation 1 | 9 days | Mon 14/10/24 | Thu 24/10/24 | Mon 14/10/... Thu 24/10/24
39 | Simulation 2 | 5 days | Tue 12/11/24 | Mon 18/11/24 | Tue 12/11/24 | Mon 18/11/...
40 | Integration | 5 days | Thu 16/01/25 | Wed 22/01/25 | NA | NA
41 | (Buffer) | 10 days | Mon 06/01/25 | Fri 17/01/25 | NA | NA
42 | Demo rehearsal | 2 days | Thu 23/01/25 | Fri 24/01/25 | NA | NA

Daniel[20%],Maxi[20%],Eren[20%]

Project: Project Schedule Date: Wed 27/11/24 | Milestone Inactive Milestone Manual Summary Rollup External Tasks Manual Progress
