Daniel-Pedraglio/ROBO.666.Robotics.Project.Work/Documents/02 - Project Schedule/Old Schedule/20240925 - Initial Project Schedule.pdf

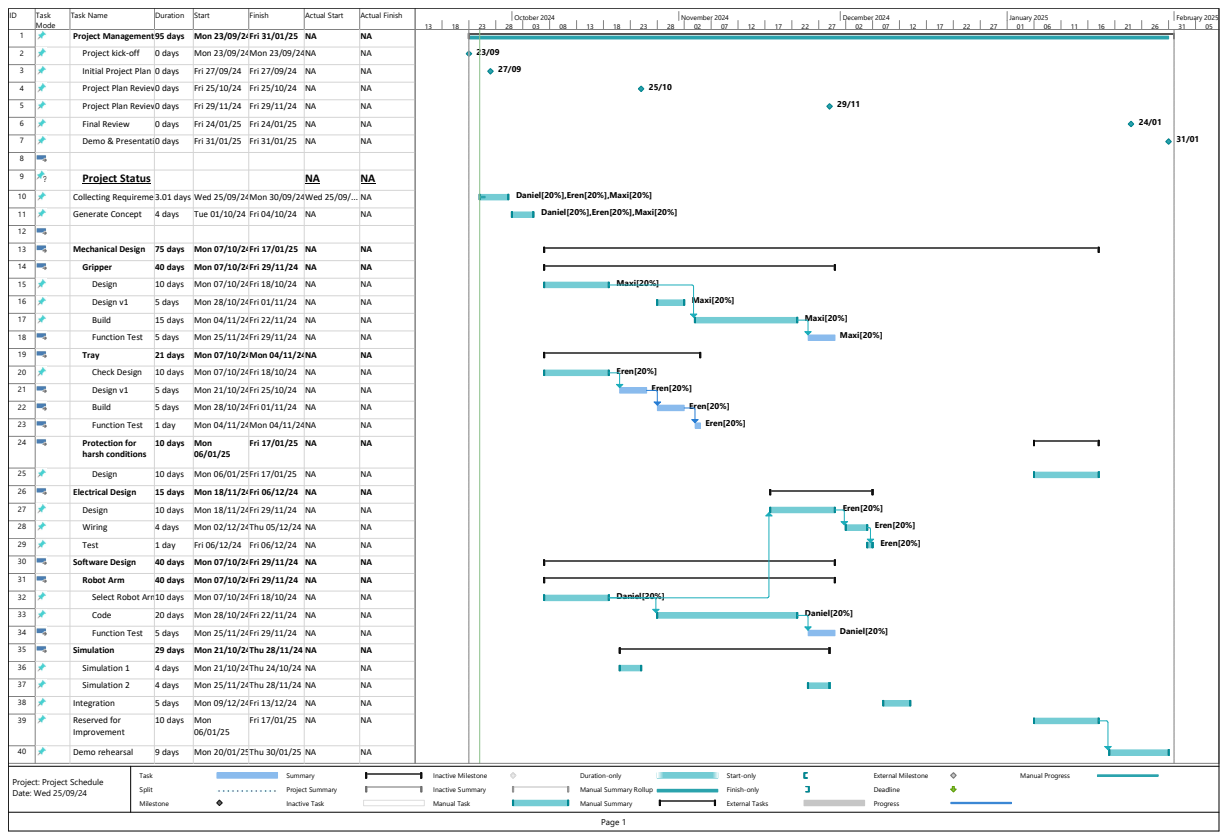
[picture p95: page 1]
Maxi[20%]; Eren[20%]; Daniel[20%]; 05 October 2024; November 2024; December 2024; January 2025; February 2025

ID | Task Mode | Task Name | Duration | Start | Finish | Actual Start | Actual Finish
1 | | Project Management95 days | | Mon 23/09/24Fri 31/01/25 | | NA | NA
2 | | Project kick-off | 0 days | Mon 23/09/24Mon 23/09/24NA | | | NA
3 | | Initial Project Plan | 0 days | Fri 27/09/24 | Fri 27/09/24 | NA | NA
4 | | Project Plan Review 10 days | | Fri 25/10/24 | Fri 25/10/24 | NA | NA
5 | | Project Plan Review 20 days | | Fri 29/11/24 | Fri 29/11/24 | NA | NA
6 | | Final Review | 0 days | Fri 24/01/25 | Fri 24/01/25 | NA | NA
7 | | Demo & Presentation0 days | | Fri 31/01/25 | Fri 31/01/25 | NA | NA
9 | | Project Status | | | | NA | NA
10 Collecting Requirement3.01 days Wed 25/09/24Mon 30/09/24Wed 25/09/... NA
11 | | Generate Concept | 4 days | Tue 01/10/24 | Fri 04/10/24 | NA | NA
12
13 | | Mechanical Design | 75 days | Mon 07/10/24Fri 17/01/25 | | NA | NA
14 | | Gripper | 40 days | Mon 07/10/24Fri 29/11/24 | | NA | NA
15 | | Design | 10 days | Mon 07/10/24Fri 18/10/24 | | NA | NA
16 | | Design v1 | 5 days | Mon 28/10/24Fri 01/11/24 | | NA | NA
17 | | Build | 15 days | Mon 04/11/24Fri 22/11/24 | | NA | NA
18 | | Function Test | 5 days | Mon 25/11/24Fri 29/11/24 | | NA | NA
19 | | Tray | 21 days | Mon 07/10/24Mon 04/11/24NA | | | NA
20 | | Check Design | 10 days | Mon 07/10/24Fri 18/10/24 | | NA | NA
21 | | Design v1 | 5 days | Mon 21/10/24Fri 25/10/24 | | NA | NA
22 | | Build | 5 days | Mon 28/10/24Fri 01/11/24 | | NA | NA
23 | | Function Test | 1 day | Mon 04/11/24Mon 04/11/24NA | | | NA
24 | | Protection for harsh conditions | 10 days | Mon 06/01/25 | Fri 17/01/25 | NA | NA

31/01 Daniel[20%],Eren[20%],Maxi[20%]

Daniel[20%],Eren[20%],Maxi[20%]

25 | | Design | 10 days | Mon 06/01/25Fri 17/01/25 | | NA | NA
26 | | Electrical Design | 15 days | Mon 18/11/24Fri 06/12/24 | | NA | NA
27 | | Design | 10 days | Mon 18/11/24Fri 29/11/24 | | NA | NA
28 | | Wiring | 4 days | Mon 02/12/24Thu 05/12/24 NA | | | NA
29 | | Test | 1 day | Fri 06/12/24 | Fri 06/12/24 | NA | NA
30 | | Software Design | 40 days | Mon 07/10/24Fri 29/11/24 | | NA | NA
31 | | Robot Arm | 40 days | Mon 07/10/24Fri 29/11/24 | | NA | NA
32 | | Select Robot Arm10 days | | Mon 07/10/24Fri 18/10/24 | | NA | NA
33 | | Code | 20 days | Mon 28/10/24Fri 22/11/24 | | NA | NA
34 | | Function Test | 5 days | Mon 25/11/24Fri 29/11/24 | | NA | NA
35 | | Simulation | 29 days | Mon 21/10/24Thu 28/11/24 NA | | | NA
36 | | Simulation 1 | 4 days | Mon 21/10/24Thu 24/10/24 NA | | | NA
37 | | Simulation 2 | 4 days | Mon 25/11/24Thu 28/11/24 NA | | | NA
38 | | Integration | 5 days | Mon 09/12/24Fri 13/12/24 | | NA | NA
39 Reserved for Improvement | | | 10 days | Mon 06/01/25 | Fri 17/01/25 | NA | NA

40 | | Demo rehearsal | 9 days | Mon 20/01/25Thu 30/01/25 NA | | | NA

Project: Project Schedule Date: Wed 25/09/24 | Task Split Milestone Summary Project Summary Inactive Milestone Inactive Summary Manual Task Duration-only Manual Summary Rollup Manual Summary Start-only Finish-only External Tasks External Milestone Deadline Progress Manual Progress Page 1 Inactive Task
